adafruit/Adafruit-STEMMA-Speaker-PCB/README.md

## Adafruit STEMMA Speaker Plug and Play Audio Amplifier PCB

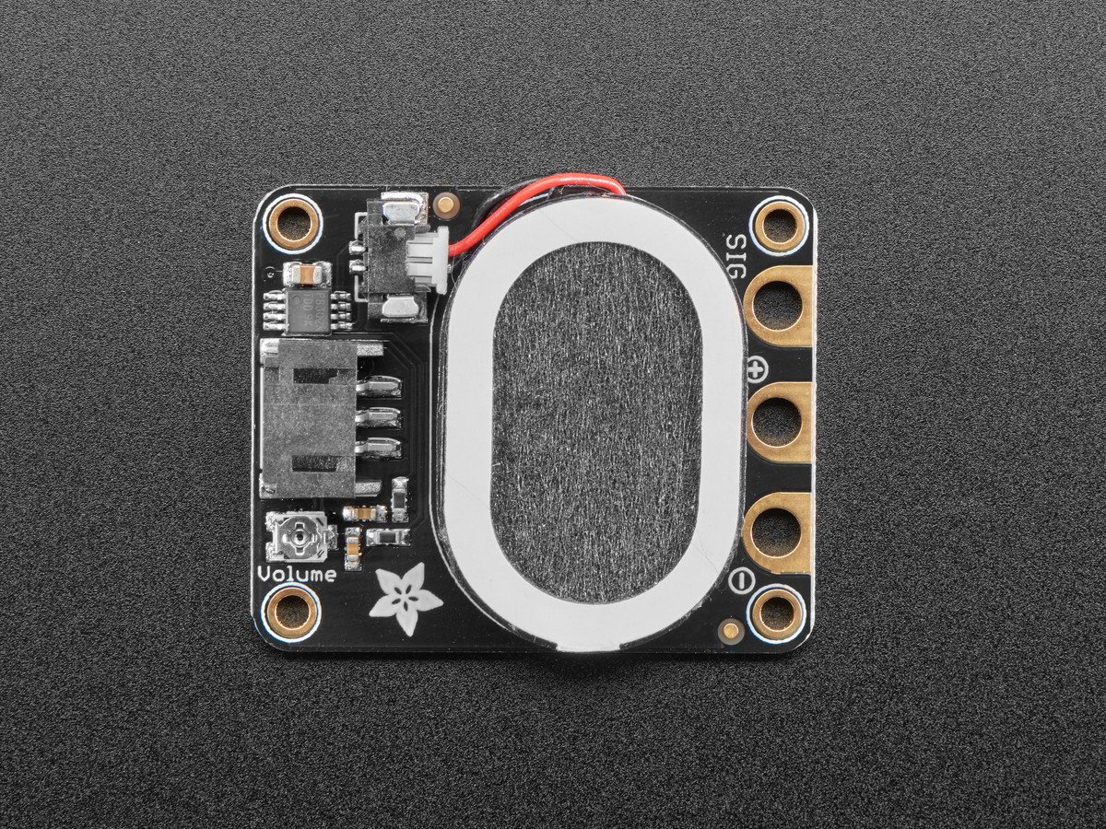
[picture p1: assets/3885.jpg]
<a href="http://www.adafruit.com/products/3885"><br/>
Click here to purchase one from the Adafruit shop</a>

PCB files for the Adafruit STEMMA Speaker Plug and Play Audio Amplifier. 

Format is EagleCAD schematic and board layout
* https://www.adafruit.com/product/3885

### Description

Hey, have you heard the good news? With Adafruit STEMMA boards you can easily and safely plug sensors and devices together, like this Adafruit STEMMA Speaker - Plug and Play Audio Amplifier. Like the name implies, it's got a class D audio amplifier on board, and our favorite little 1 Watt 8 ohm speaker.

Connecting it up is easy - you only need ground, 3 to 5V power, and audio signal. The audio signal does not need to be AC coupled, we do that for you, and can range up to the power pin voltage (3 or 5V peak-to-peak). You can use either the 3-pin JST socket or the alligator/sew-pads for this slim and portable package. The sound quality is good enough for music, tones, speech, whatever you like and volume can be adjusted with a small screwdriver.

For use with a CircuitPlayground or micro:bit, this JST to alligator-clip cable works best. Red is power, ground is black and signal is white.

For use with a breadboard, try this JST to male/plug-header. (We also have a socket-header cable if you want)

### License

Adafruit invests time and resources providing this open source design, please support Adafruit and open-source hardware by purchasing products from [Adafruit](https://www.adafruit.com)!

Designed by Limor Fried/Ladyada for Adafruit Industries.

Creative Commons Attribution/Share-Alike, all text above must be included in any redistribution. 
See license.txt for additional details.
