adafruit/Adafruit-STEMMA-Speaker-PCB/Adafruit STEMMA Speaker.brd

## EAGLE design Adafruit STEMMA Speaker.brd (2019-10-03)

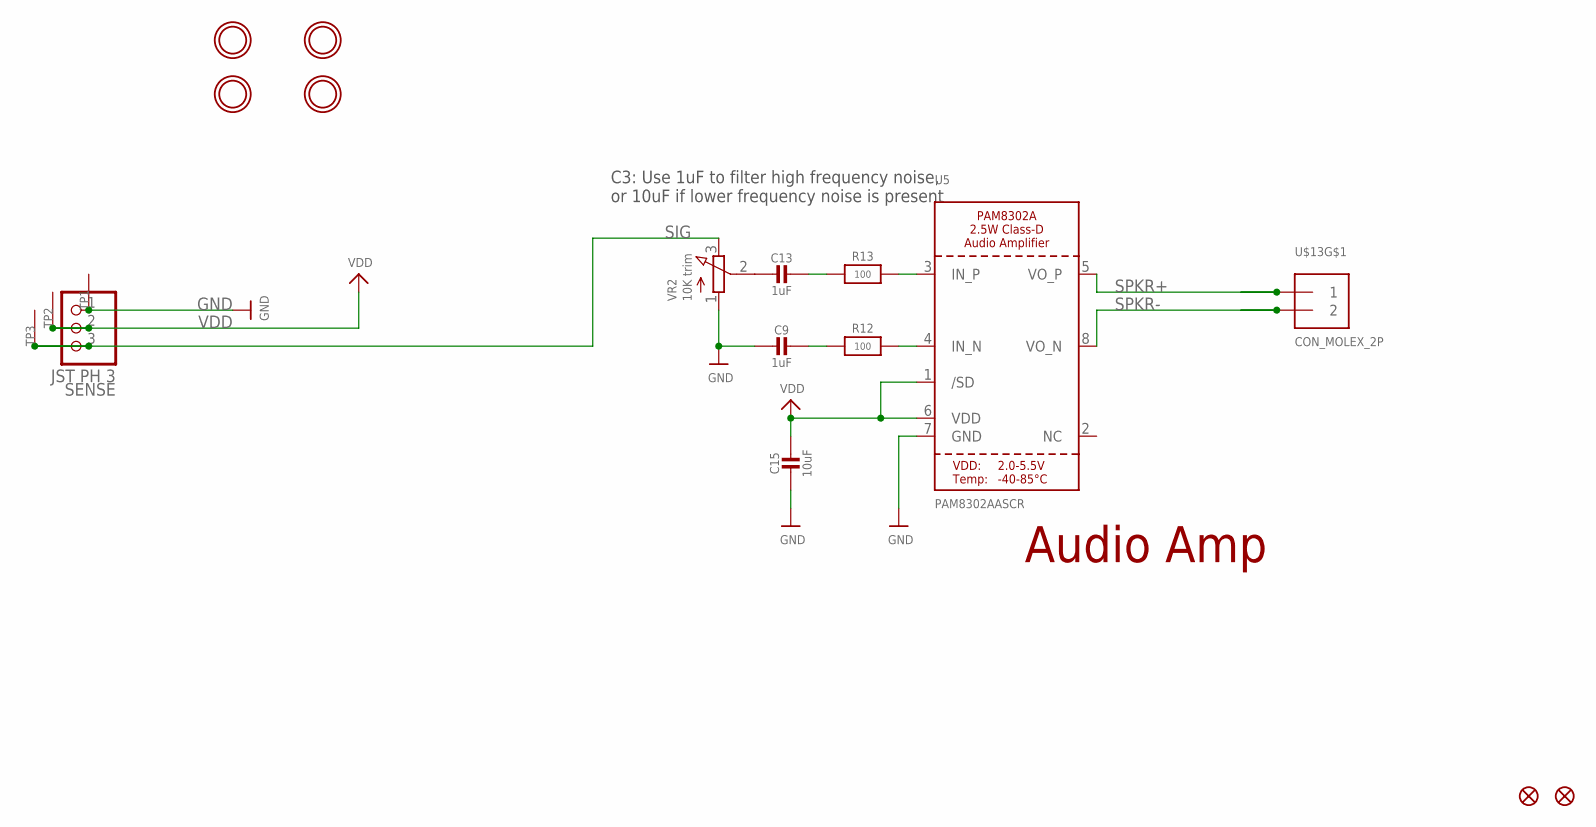
[picture p2: schematic Adafruit STEMMA Speaker.sch]

Parts:
C9, C13: 1uF; 0603-NO
C15: 10uF; 0805-NO
FID1, FID2: FIDUCIAL_1MM
R12, R13: 100; 0603-NO
SENSE: JST PH 3; JSTPH3
TP1, TP2, TP3: SEWTAPPCB_ALLIGATOR; PCB_ALLI
U5: PAM8302AASCR; MSOP8_0.65MM
U$9, U$10, U$11, U$12: MOUNTINGHOLE2.0; MOUNTINGHOLE_2.0_PLATED
U$13: CON_MOLEX_2P; 53398-0271
VR2: 10K trim; TRIMPOT_BOURNS_3303W

Connections:
GND: C9.2, C15.2, SENSE.1, TP1.P$1, U5.7 (GND), VR2.1 (A)
unnamed: R12.2, U5.4 (IN_N)
unnamed: R13.2, U5.3 (IN_P)
unnamed: C9.1, R12.1
unnamed: C13.1, R13.1
unnamed: C13.2, VR2.2 (S)
SIG: SENSE.3, TP3.P$1, VR2.3 (E)
SPKR+: U5.5 (VO_P), U$13.1
SPKR-: U5.8 (VO_N), U$13.2
VDD: C15.1, SENSE.2, TP2.P$1, U5.1 (/SD), U5.6 (VDD)

Notes on the sheet:
C3: Use 1uF to filter high frequency noise, or 10uF if lower frequency noise is present
Audio Amp

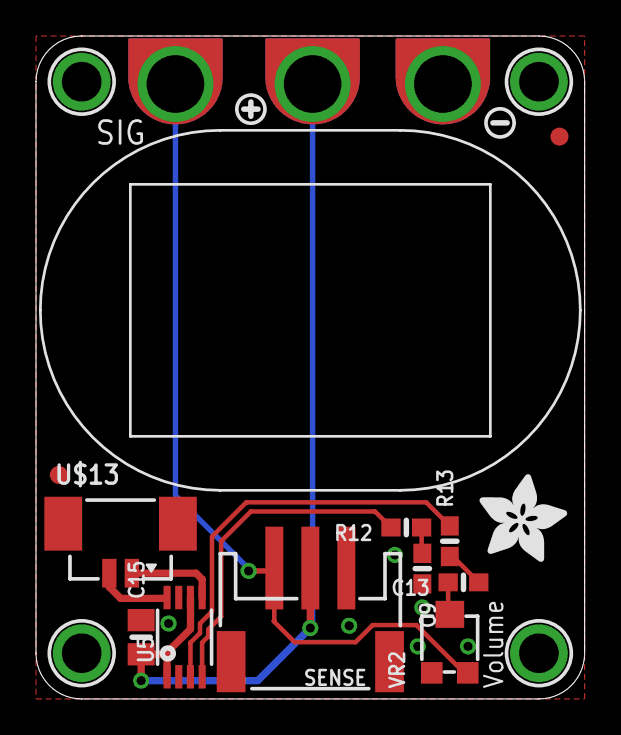
[picture p3: board Adafruit STEMMA Speaker.brd from above]

Board: 2 copper layers, 30.5 x 36.8 mm, 23 parts (1 on the bottom side), 10 nets.

Other parts of the board:
U$1: SPEAKER_OVAL8OHM
U$3: ADAFRUIT_5MM
U$4: STEMMA_SPEAKER
U$5: SYMBOL_MINUS
U$6: SYMBOL_PLUS
